kartikeyy12/aqsense-power-quality-sentinel/simulation/models/LTSpice_Circuit.png

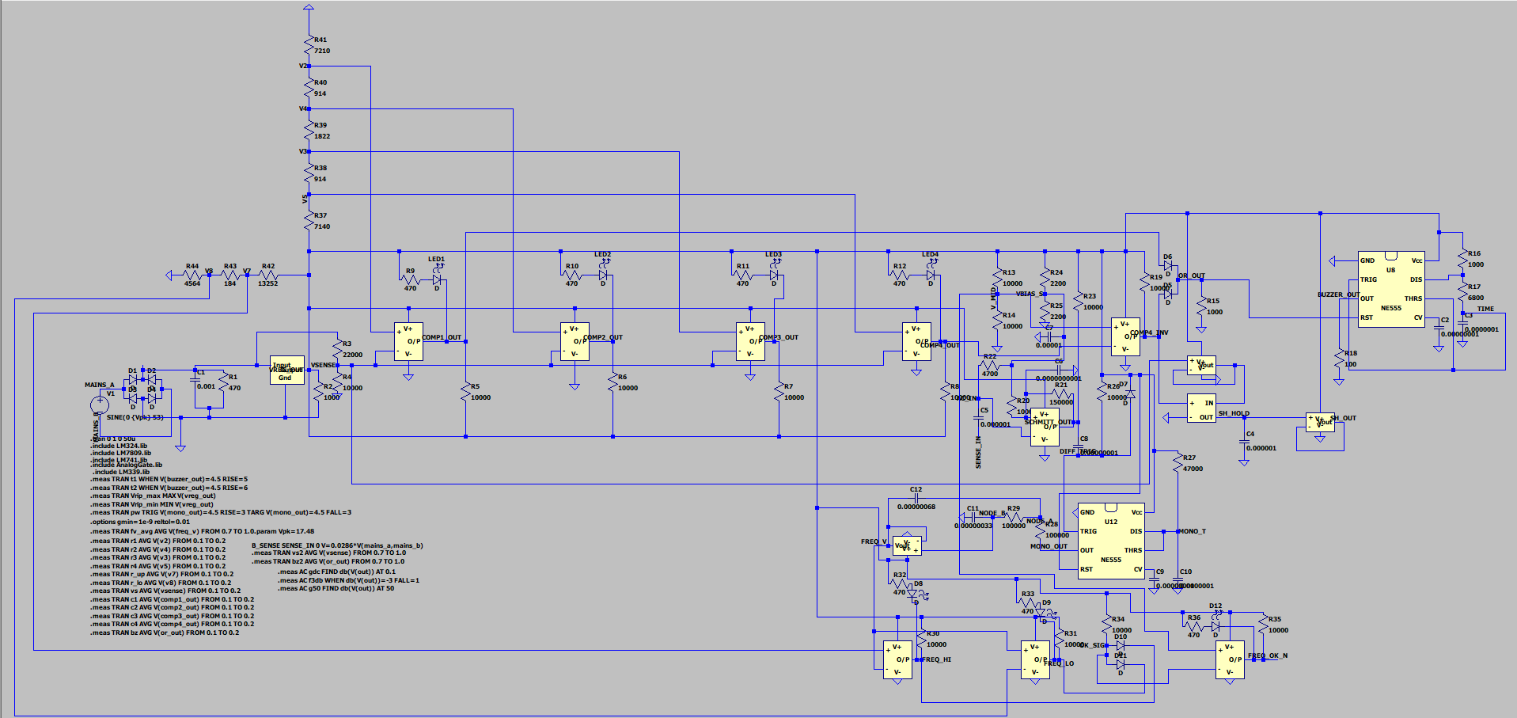
simulation/models/LTSpice_Circuit.png
