kartikeyy12/aqsense-power-quality-sentinel/twin/out/r19_sweep.png

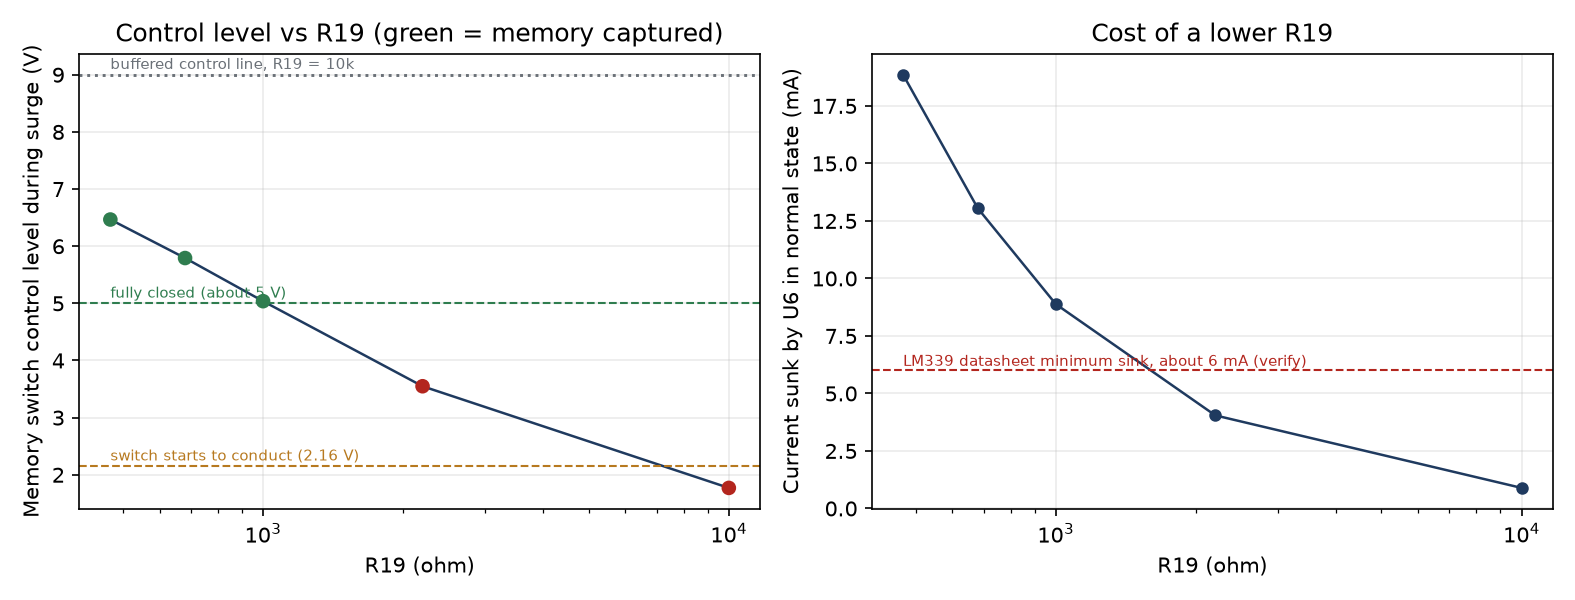
twin/out/r19_sweep.png
