kartikeyy12/aqsense-power-quality-sentinel/twin/out/characterisation.csv

signal | unit | design | up_ramp | down_ramp | mean | offset | up_minus_down
LED1 | V | 180 | 182.750 | 182.383 | 182.567 | 2.567 | 0.367
LED2 | V | 200 | 203.650 | 203.283 | 203.467 | 3.467 | 0.367
LED3 | V | 240 | 244.717 | 244.350 | 244.533 | 4.533 | 0.367
LED4 | V | 260 | 267.817 | 267.450 | 267.633 | 7.633 | 0.367
FREQ_LO flag | Hz | 49 | 49.056 | 48.832 | 48.944 | -0.056 | 0.224
FREQ_HI flag | Hz | 51 | 51.072 | 50.784 | 50.928 | -0.072 | 0.288
