kartikeyy12/aqsense-power-quality-sentinel/twin/out/characterisation.png

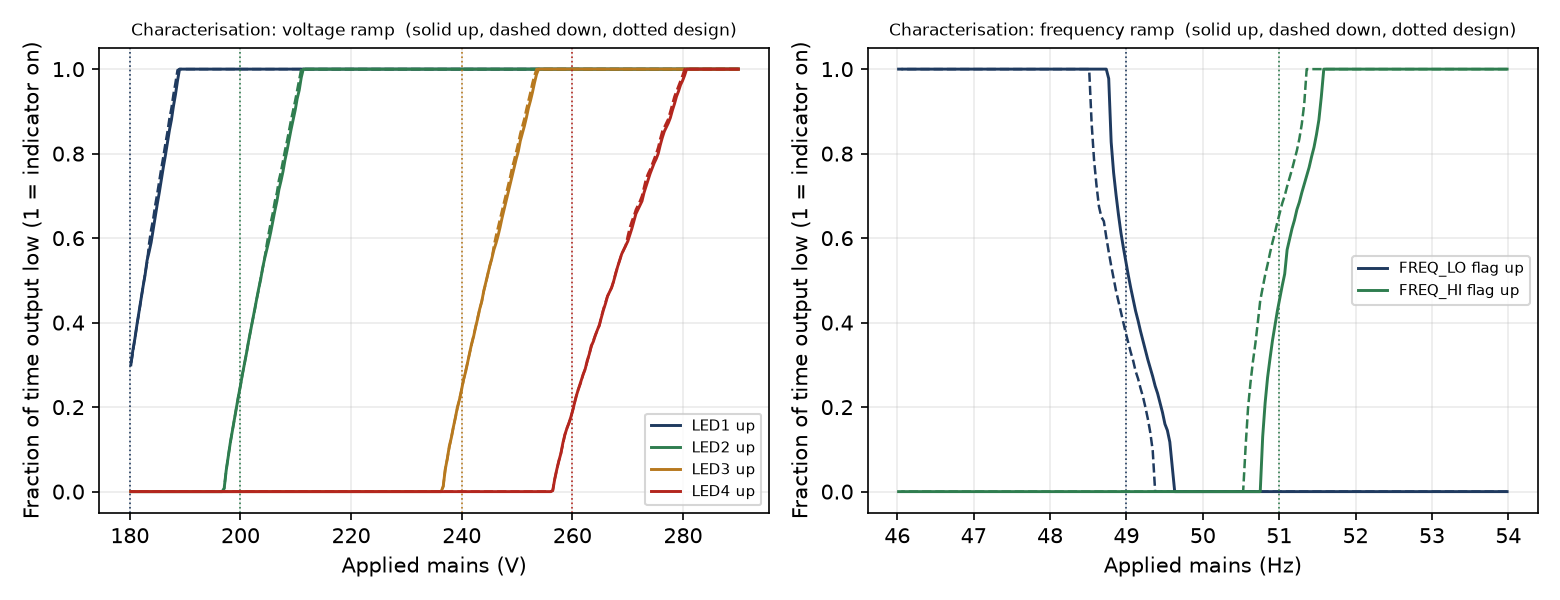
twin/out/characterisation.png
