kartikeyy12/aqsense-power-quality-sentinel/simulation/LIC_LabProject.asc

C1: cap; 0.001
C2: cap; 0.00000001
C3: cap; 0.0000001
C4: cap; 0.000001
C5: cap; 0.000001
C6: cap; 0.0000000001
C7: cap; 0.00001
C8: cap; 0.00000001
C9: cap; 0.00000001
C10: cap; 0.0000001
C11: cap; 0.00000033
C12: cap; 0.00000068
D1: diode
D2: diode
D3: diode
D4: diode
D5: diode
D6: diode
D7: diode
D8: LED
D9: LED
D10: diode
D11: diode
D12: LED
LED1: LED
LED2: LED
LED3: LED
LED4: LED
R1: res; 470
R2: res; 1000
R3: res; 22000
R4: res; 10000
R5: res; 10000
R6: res; 10000
R7: res; 10000
R8: res; 10000
R9: res; 470
R10: res; 470
R11: res; 470
R12: res; 470
R13: res; 10000
R14: res; 10000
R15: res; 1000
R16: res; 1000
R17: res; 6800
R18: res; 100
R19: res; 10000
R20: res; 10000
R21: res; 150000
R22: res; 4700
R23: res; 10000
R24: res; 2200
R25: res; 2200
R26: res; 10000
R27: res; 47000
R28: res; 100000
R29: res; 100000
R30: res; 10000
R31: res; 10000
R32: res; 470
R33: res; 470
R34: res; 10000
R35: res; 10000
R36: res; 470
R37: res; 7140
R38: res; 914
R39: res; 1822
R40: res; 914
R41: res; 7210
R42: res; 13252
R43: res; 184
R44: res; 4564
U1: LM7809
U2: LM339
U3: LM339
U4: LM339
U5: LM339
U6: LM339
U7: AnalogGate
U8: NE555
U9: LM324
U10: LM324
U11: LM339
U12: NE555
U13: LM324
U14: LM339
U15: LM339
U16: LM339
V1: voltage; SINE(0 {Vpk} 53)
Named nets: 0, VSENSE, COMP1_OUT, VREG_OUT, COMP2_OUT, COMP3_OUT, COMP4_OUT, V_MID, COMP4_INV, OR_OUT, TIME, BUZZER_OUT, SH_HOLD, SH_OUT, AC_IN, SCHMITT_OUT, VBIAS_S, MONO_OUT, DIFF_TRIG, MONO_T, NODE_A, NODE_B, FREQ_V, FREQ_HI, FREQ_LO, OK_SIG, FREQ_OK_N, V5, V3, V4, V2, V7, V8, MAINS_A, MAINS_B, SENSE_IN
.tran 0 1 0 50u
.include LM324.lib
.include LM7809.lib
.include LM741.lib
.include LM339.lib
.meas TRAN Vrip_max MAX V(vreg_out)
.meas TRAN Vrip_min MIN V(vreg_out)
.meas TRAN t1 WHEN V(buzzer_out)=4.5 RISE=5
.meas TRAN t2 WHEN V(buzzer_out)=4.5 RISE=6
.include AnalogGate.lib
.options gmin=1e-9 reltol=0.01
.meas TRAN pw TRIG V(mono_out)=4.5 RISE=3 TARG V(mono_out)=4.5 FALL=3
.meas TRAN fv_avg AVG V(freq_v) FROM 0.7 TO 1.0
.meas TRAN r1 AVG V(v2) FROM 0.1 TO 0.2
.meas TRAN r2 AVG V(v4) FROM 0.1 TO 0.2
.meas TRAN r3 AVG V(v3) FROM 0.1 TO 0.2
.meas TRAN r4 AVG V(v5) FROM 0.1 TO 0.2
.meas TRAN r_up AVG V(v7) FROM 0.1 TO 0.2
.meas TRAN r_lo AVG V(v8) FROM 0.1 TO 0.2
.meas TRAN vs AVG V(vsense) FROM 0.1 TO 0.2
.meas TRAN c1 AVG V(comp1_out) FROM 0.1 TO 0.2
.meas TRAN c2 AVG V(comp2_out) FROM 0.1 TO 0.2
.meas TRAN c3 AVG V(comp3_out) FROM 0.1 TO 0.2
.meas TRAN c4 AVG V(comp4_out) FROM 0.1 TO 0.2
.meas TRAN bz AVG V(or_out) FROM 0.1 TO 0.2
.param Vpk=17.48
B_SENSE SENSE_IN 0 V=0.0286*V(mains_a,mains_b)
.meas TRAN vs2 AVG V(vsense) FROM 0.7 TO 1.0
.meas TRAN bz2 AVG V(or_out) FROM 0.7 TO 1.0
.meas AC gdc FIND db(V(out)) AT 0.1
.meas AC f3db WHEN db(V(out))=-3 FALL=1
.meas AC g50 FIND db(V(out)) AT 50
