kartikeyy12/aqsense-power-quality-sentinel/(commit log)

2026-10-08 AQSENSE: analog mains power quality sentinel (LTspice)
2026-11-04 Peak-based applied-voltage readout; update guide with measured findings
2026-11-06 R19 sweep, buffered memory control, characterisation ramps (solver tweaks noted)
    [characterisation.csv, r19_sweep.csv]
